dioannidis/usbaispuart/README.md

# USBaispUART

( version 5 )

   A single side, through hole, USBa(i)sp clone, designed in Kicad 5.

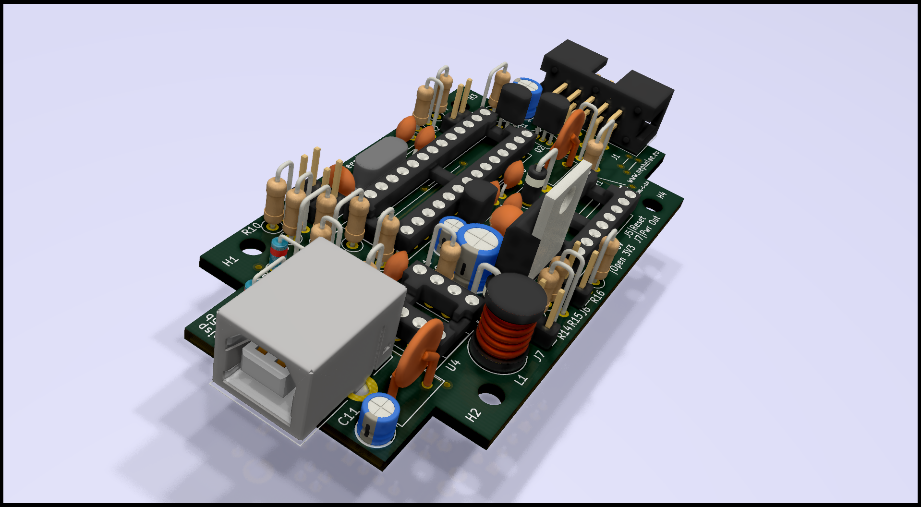
[picture p1: hardware/IMAGES/usbaispuart_front_components_raytracing.png]
