dioannidis/usbaispuart/hardware/IMAGES/usbaispuart_back.png

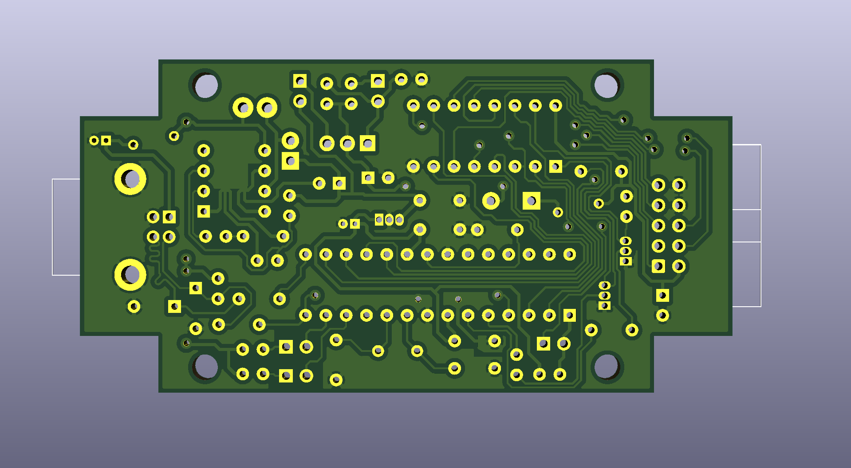
hardware/IMAGES/usbaispuart_back.png
