dioannidis/usbaispuart/hardware/IMAGES/usbaispuart_device.jpg

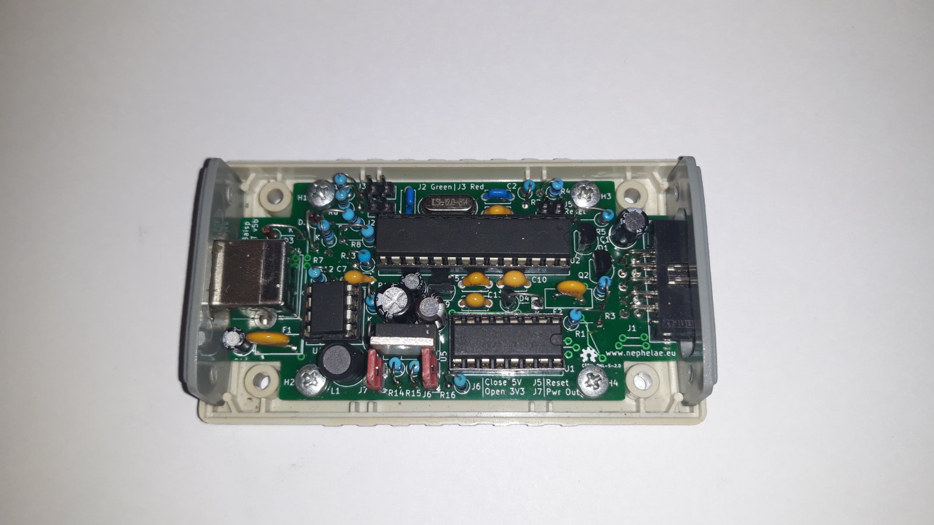
hardware/IMAGES/usbaispuart_device.jpg
