dioannidis/usbaispuart/hardware/IMAGES/usbaispuart_front.png

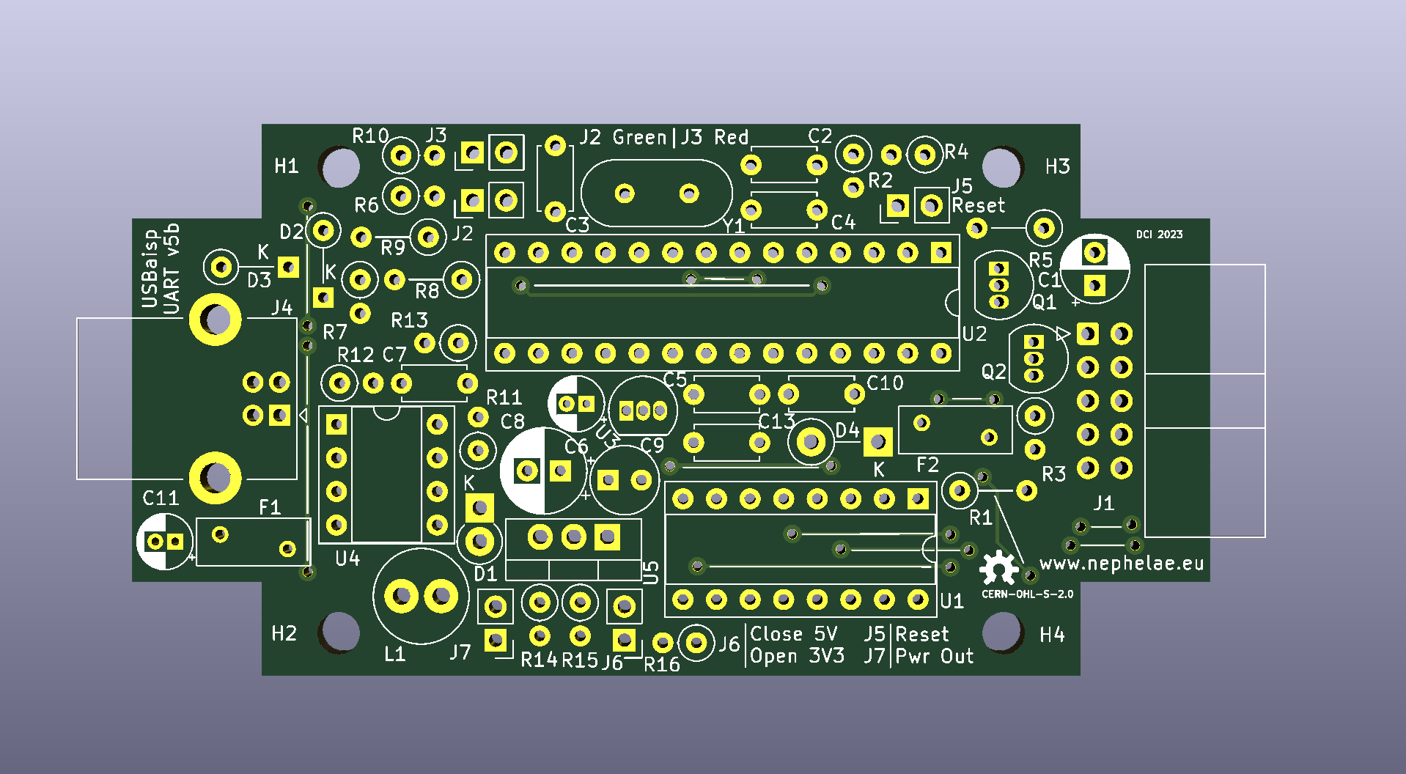
hardware/IMAGES/usbaispuart_front.png
