dioannidis/usbaispuart/hardware/IMAGES/usbaispuart_front_components.png

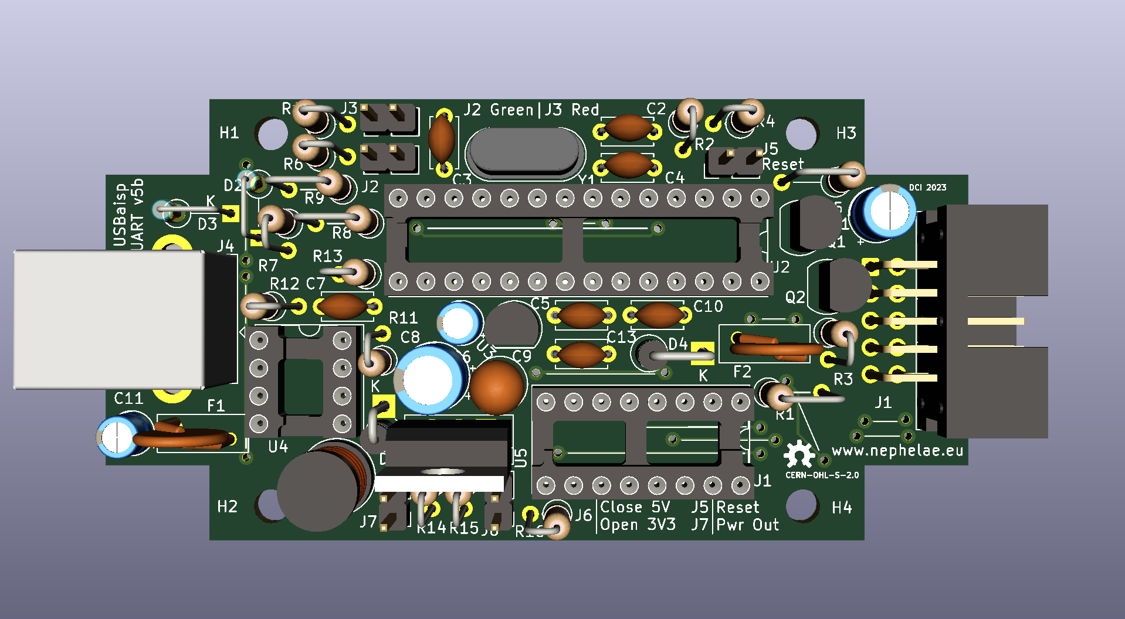
hardware/IMAGES/usbaispuart_front_components.png
