dioannidis/usbaispuart/hardware/LIB_3D/USB 2.0 Type B Connector Right Angle (Würth 61400416121).stp

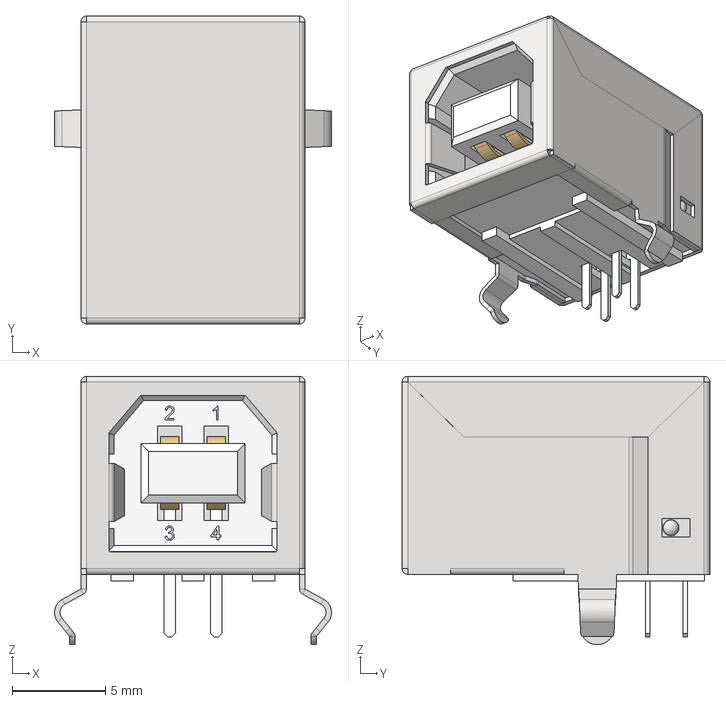
[picture p6: CAD file, 2022-08-16]
hardware/LIB_3D/USB 2.0 Type B Connector Right Angle (Würth 61400416121).stp
14.8 x 16.5 x 14.4 mm
