dioannidis/usbaispuart/hardware/PDF/usbaispuart.pdf

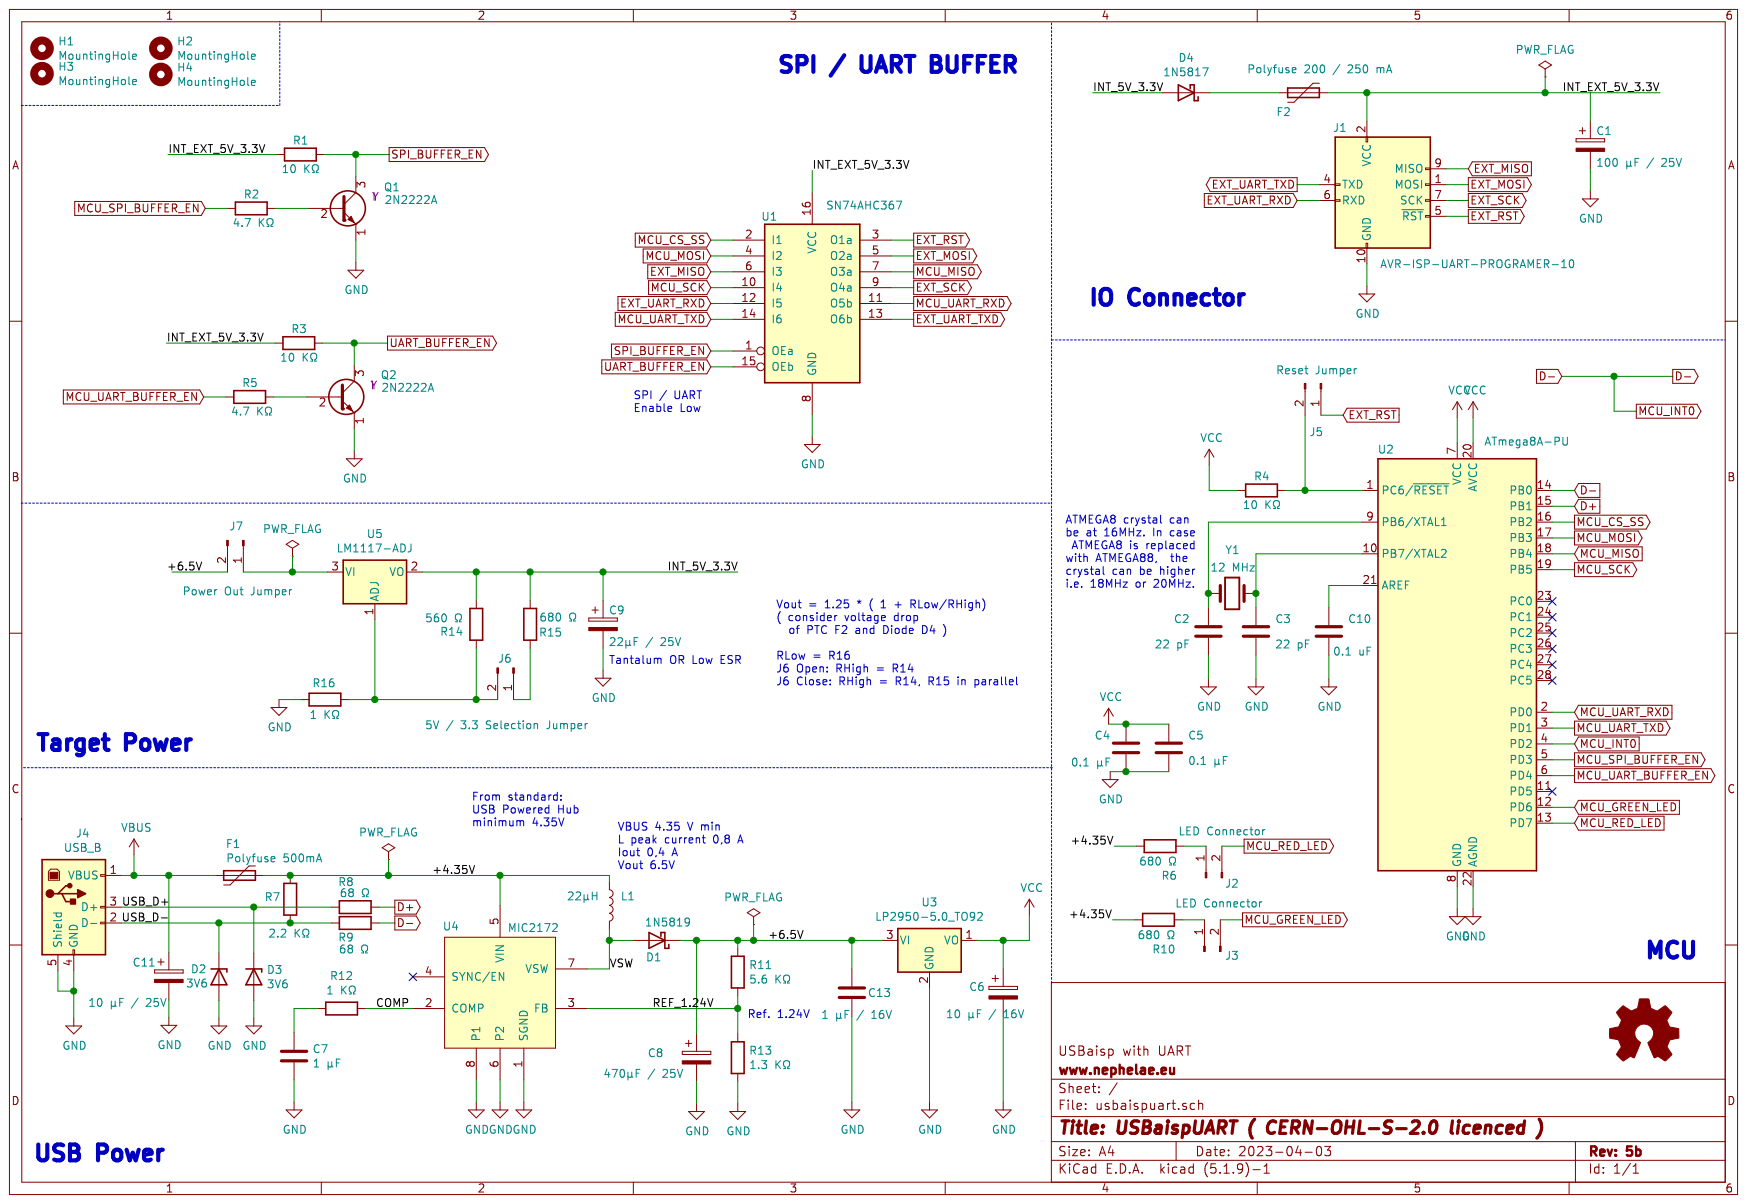
[picture p7: page 1]
