dioannidis/usbaispuart/hardware/KiCAD/usbaispuart/usbaispuart.kicad_pcb

## KiCad design hardware/KiCAD/usbaispuart/usbaispuart.kicad_pcb (2023-05-03)

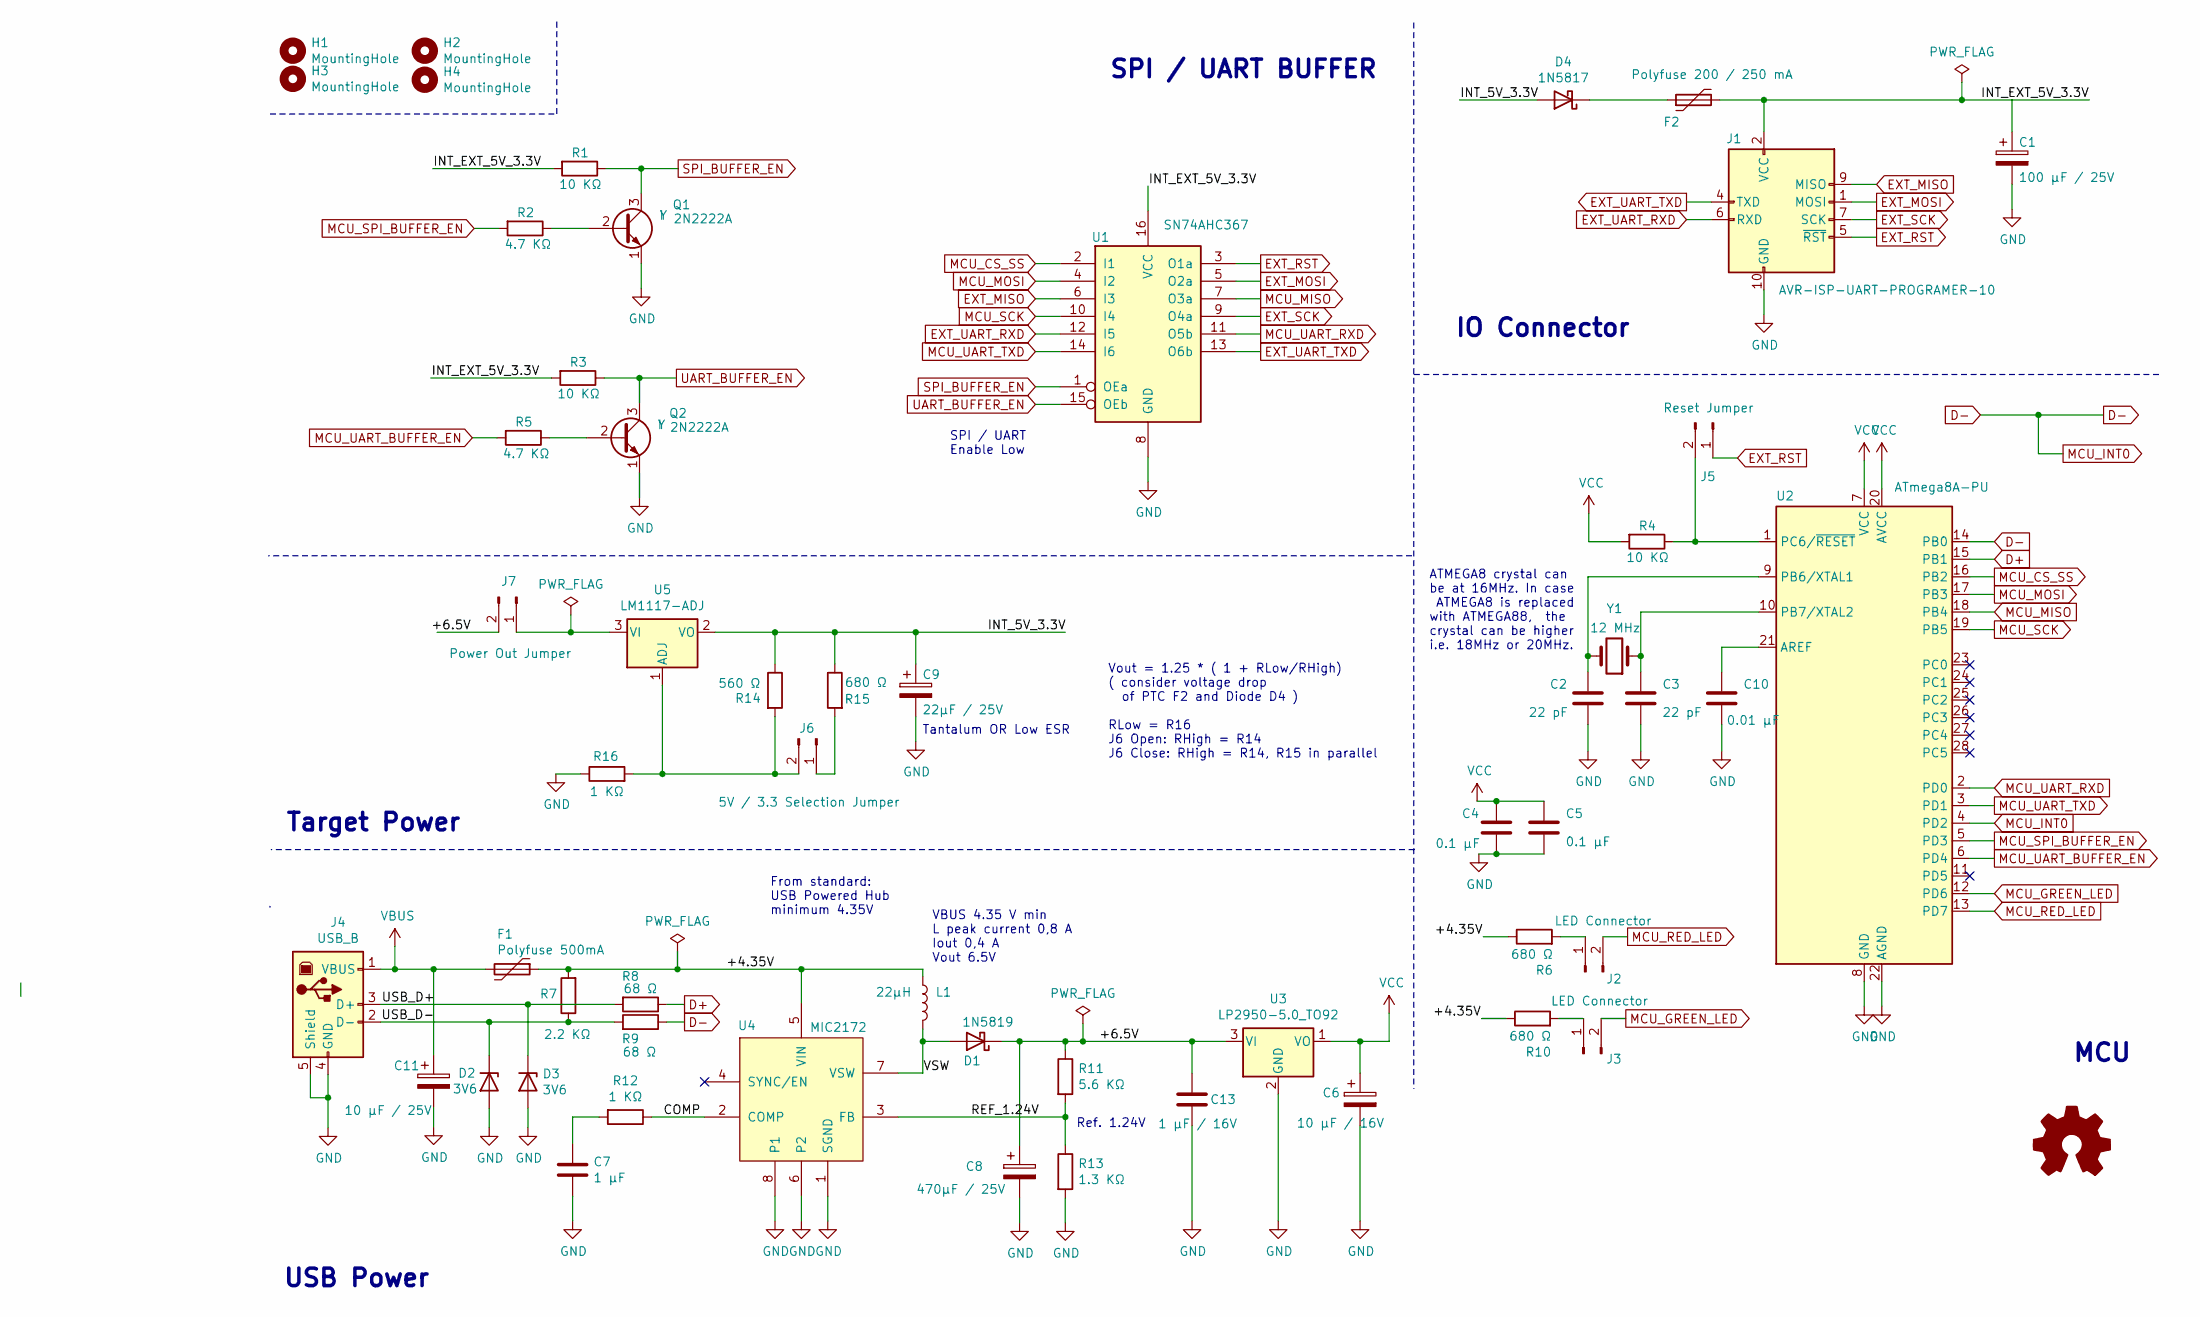
[picture p8: schematic usbaispuart.sch, USBaispUART ( CERN-OHL-S-2.0 licenced )]

Parts:
C1: 100 μF / 25V; CP_Radial_D5.0mm_P2.50mm
C2, C3: 22 pF; C_Disc_D4.7mm_W2.5mm_P5.00mm
C4, C5: 0.1 μF; C_Disc_D4.7mm_W2.5mm_P5.00mm
C6: 10 μF / 16V; CP_Radial_D4.0mm_P1.50mm
C7: 1 μF; C_Disc_D4.7mm_W2.5mm_P5.00mm
C8: 470μF / 25V; CP_Radial_D6.3mm_P2.50mm
C9: 22μF / 25V; CP_Radial_Tantal_D5.0mm_P2.50mm
C10: 0.01 μF; C_Disc_D4.7mm_W2.5mm_P5.00mm
C11: 10 μF / 25V; CP_Radial_D4.0mm_P1.50mm
C13: 1 μF / 16V; C_Disc_D4.7mm_W2.5mm_P5.00mm
D1: 1N5819; D_DO-41_SOD81_P2.54mm_Vertical_KathodeUp
D2, D3: 3V6; D_DO-35_SOD27_P5.08mm_Vertical_KathodeUp
D4: 1N5817; D_DO-41_SOD81_P5.08mm_Vertical_KathodeUp
F1: Polyfuse 500mA; Fuse_ECE_RA02560_L7.4mm_W3.1mm
F2: Polyfuse 200 / 250 mA; Fuse_ECE_RA02560_L7.4mm_W3.1mm
H1, H2, H3, H4: MountingHole; MountingHole_3.2mm_M3_DIN965
J1: AVR-ISP-UART-PROGRAMER-10; IDC-Header_2x05_P2.54mm_Horizontal
J2, J3: LED Connector; PinHeader_1x02_P2.54mm_Vertical
J4: USB_B; USB_B_Lumberg_2411_02_Horizontal
J5: Reset Jumper; PinHeader_1x02_P2.54mm_Vertical
J6: 5V / 3.3 Selection Jumper; PinHeader_1x02_P2.54mm_Vertical
J7: Power Out Jumper; PinHeader_1x02_P2.54mm_Vertical
L1: 22μH; L_Radial_D7.0mm_P3.00mm
Q1, Q2: 2N2222A; TO-92_Inline
R1: 10 KΩ; R_Axial_DIN0207_L6.3mm_D2.5mm_P5.08mm_Vertical
R2: 4.7 KΩ; R_Axial_DIN0207_L6.3mm_D2.5mm_P2.54mm_Vertical
R3, R4: 10 KΩ; R_Axial_DIN0207_L6.3mm_D2.5mm_P2.54mm_Vertical
R5: 4.7 KΩ; R_Axial_DIN0207_L6.3mm_D2.5mm_P5.08mm_Vertical
R6, R10, R15: 680 Ω; R_Axial_DIN0207_L6.3mm_D2.5mm_P2.54mm_Vertical
R7: 2.2 KΩ; R_Axial_DIN0207_L6.3mm_D2.5mm_P2.54mm_Vertical
R8, R9: 68 Ω; R_Axial_DIN0207_L6.3mm_D2.5mm_P5.08mm_Vertical
R11: 5.6 KΩ; R_Axial_DIN0207_L6.3mm_D2.5mm_P2.54mm_Vertical
R12, R16: 1 KΩ; R_Axial_DIN0207_L6.3mm_D2.5mm_P2.54mm_Vertical
R13: 1.3 KΩ; R_Axial_DIN0207_L6.3mm_D2.5mm_P2.54mm_Vertical
R14: 560 Ω; R_Axial_DIN0207_L6.3mm_D2.5mm_P2.54mm_Vertical
U1: SN74AHC367; DIP-16_W7.62mm_Socket
U2: ATmega8A-PU; DIP-28_W7.62mm_Socket
U3: LP2950-5.0_TO92; TO-92_Inline
U4: MIC2172; DIP-8_W7.62mm_Socket
U5: LM1117-ADJ; TO-220-3_Vertical
Y1: 12 MHz; Crystal_HC49-4H_Vertical

Connections:
/+4.35V: F1.1, L1.1, R6.1, R7.2, R10.1, U4.5 (VIN)
/+6.5V: C8.1, C13.1, D1.1 (K), J7.2, R11.1, U3.3 (VI)
/COMP: R12.1, U4.2 (COMP)
/INT_5V_3.3V: C9.1, D4.2 (A), R14.1, R15.1, U5.2 (VO)
/INT_EXT_5V_3.3V: C1.1, F2.2, J1.2 (VCC), R1.2, R3.2, U1.16 (VCC)
/REF_1.24V: R11.2, R13.1, U4.3 (FB)
/USB_D+: D3.1 (K), J4.3 (D+), R8.2
/USB_D-: D2.1 (K), J4.2 (D-), R7.1, R9.2
/VSW: D1.2 (A), L1.2, U4.7 (VSW)
D+: R8.1, U2.15 (PB1)
D-: R9.1, U2.4 (PD2), U2.14 (PB0)
EXT_MISO: J1.9 (MISO), U1.6 (I3)
EXT_MOSI: J1.1 (MOSI), U1.5 (O2a)
EXT_RST: J1.5 (~RST), J5.1, U1.3 (O1a)
EXT_SCK: J1.7 (SCK), U1.9 (O4a)
EXT_UART_RXD: J1.6 (RXD), U1.12 (I5)
EXT_UART_TXD: J1.4 (TXD), U1.13 (O6b)
GND: C1.2, C2.2, C3.2, C4.2, C5.2, C6.2, C7.2, C8.2, C9.2, C10.2, C11.2, C13.2, D2.2 (A), D3.2 (A), J1.8 (GND), J1.10 (GND), J4.4 (GND), J4.5 (Shield), Q1.1 (E), Q2.1 (E), R13.2, R16.1, U1.8 (GND), U2.8 (GND), U2.22 (AGND), U3.2 (GND), U4.1 (SGND), U4.6 (P2), U4.8 (P1)
MCU_CS_SS: U1.2 (I1), U2.16 (PB2)
MCU_GREEN_LED: J3.2, U2.12 (PD6)
MCU_MISO: U1.7 (O3a), U2.18 (PB4)
MCU_MOSI: U1.4 (I2), U2.17 (PB3)
MCU_RED_LED: J2.2, U2.13 (PD7)
MCU_SCK: U1.10 (I4), U2.19 (PB5)
MCU_SPI_BUFFER_EN: R2.2, U2.5 (PD3)
MCU_UART_BUFFER_EN: R5.2, U2.6 (PD4)
MCU_UART_RXD: U1.11 (O5b), U2.2 (PD0)
MCU_UART_TXD: U1.14 (I6), U2.3 (PD1)
unnamed: C2.1, U2.9 (PB6/XTAL1), Y1.2
unnamed: C3.1, U2.10 (PB7/XTAL2), Y1.1
unnamed: C7.1, R12.2
unnamed: C10.1, U2.21 (AREF)
unnamed: D4.1 (K), F2.1
unnamed: J2.1, R6.2
unnamed: J3.1, R10.2
unnamed: J5.2, R4.1, U2.1 (PC6/~RESET)
unnamed: J6.1, R15.2
unnamed: J6.2, R14.2, R16.2, U5.1 (ADJ)
unnamed: J7.1, U5.3 (VI)
unnamed: Q1.2 (B), R2.1
unnamed: Q2.2 (B), R5.1
SPI_BUFFER_EN: Q1.3 (C), R1.1, U1.1 (OEa)
UART_BUFFER_EN: Q2.3 (C), R3.1, U1.15 (OEb)
VBUS: C11.1, F1.2, J4.1 (VBUS)
VCC: C4.1, C5.1, C6.1, R4.2, U2.7 (VCC), U2.20 (AVCC), U3.1 (VO)

Notes on the sheet:
Ref. 1.24V
USB Power
MCU
SPI / UART BUFFER
IO Connector
VBUS 4.35 V min L peak current 0,8 A Iout 0,4 A Vout 6.5V
ATMEGA8 crystal can be at 16MHz. In case ATMEGA8 is replaced with ATMEGA88, the crystal can be higher i.e. 18MHz or 20MHz.
From standard: USB Powered Hub minimum 4.35V
Target Power
SPI / UART Enable Low
Vout = 1.25 * ( 1 + RLow/RHigh) ( consider voltage drop of PTC F2 and Diode D4 ) RLow = R16 J6 Open: RHigh = R14 J6 Close: RHigh = R14, R15 in parallel
Tantalum OR Low ESR

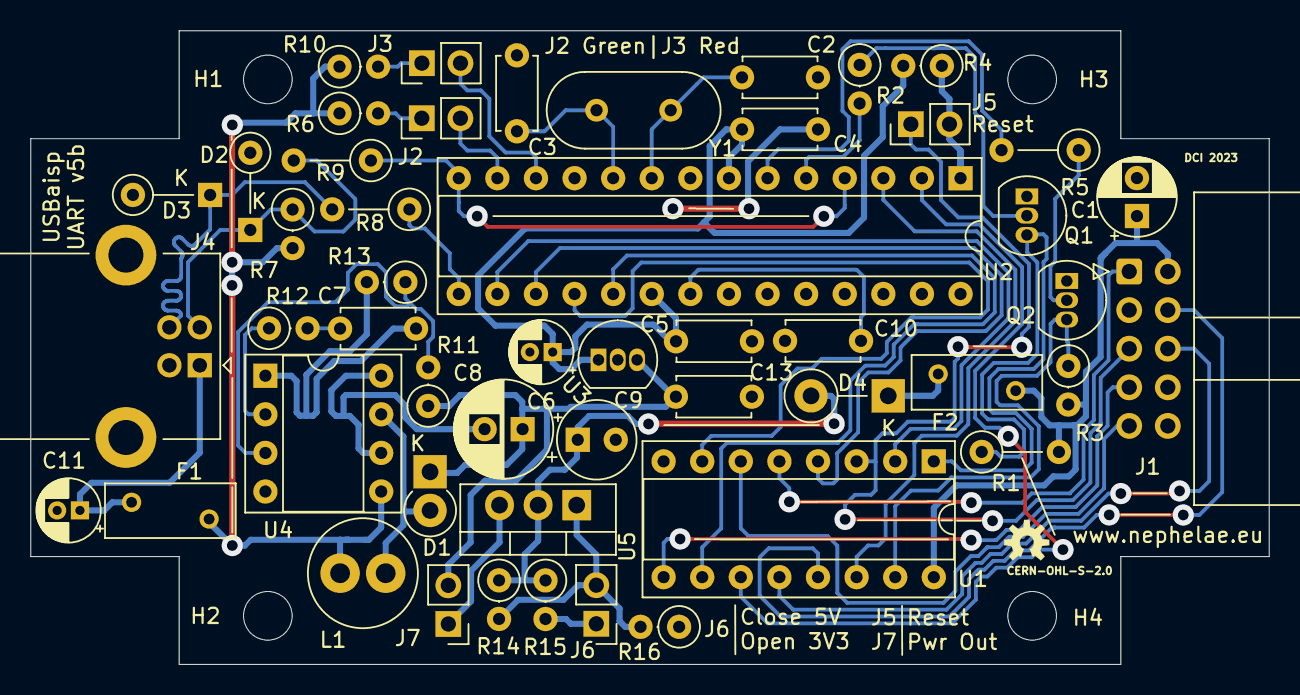
[picture p9: board usbaispuart.kicad_pcb from above]

Board: 2 copper layers, 81.5 x 41.7 mm, 54 parts (0 on the bottom side), 45 nets.
