dioannidis/usbaispuart/(commit log)

2022-08-16 Add usbaispuart hardware files.
    [USB 2.0 Type B Connector Right Angle (Würth 61400416121).stp, usbaispuart.kicad_pcb, usbaispuart.sch]
2022-08-17 Repository refactoring ....
    [USB 2.0 Type B Connector Right Angle (Würth 61400416121).stp, usbaispuart.kicad_pcb, usbaispuart.sch]
2022-12-30 Fixed an error on 2N2222A symbol.
    + Added 2N2222A datasheet.
    + Regenerate PCB images.
    [usbaispuart.kicad_pcb, usbaispuart.sch]
2022-12-30 Change D4 from 1N5819 to the correct 1N5817
    [usbaispuart.kicad_pcb, usbaispuart.sch]
2022-12-30 Regenerate schematic PDF
2022-12-30 Fixed silkscreen.
    + Regenerate gerber files.
    [usbaispuart.kicad_pcb]
2022-12-30 Regenerate PCB images.
2023-01-04 Bump version to 5a. + Fix an error trace. + Change C6 capacitor to electrolytic. + Rearrange layout to reduce noise.
    [usbaispuart.kicad_pcb, usbaispuart.sch]
2023-05-03 Update to 5b
    [usbaispuart.kicad_pcb, usbaispuart.sch]
2023-05-03 Add USBaisp assembled device image
2023-06-06 Disabling the doubling SCK clock speed after PE fixes the read errors. Need to investigate more
    [isp.c]
